greenhand520/AutomaticObstacleAvoidanceTrolleyWithC51/(list of files, drawings)

Other design files:
简易仿真图/car.pdsprj
