greenhand520/AutomaticObstacleAvoidanceTrolleyWithC51/(commit log)

2018-11-26 20181126 1934 第2次提交
    update readme.md；
    添加材料清单；
    用python写了个简易控制小车的上位机代码
2018-11-28 20181128 2148 第3次提交
    基本小车代码的框架；
    用Proteus弄了个简易的仿真；
    bug还有很多，慢慢修复。
    [car.pdsprj]
2018-12-09 20181209 2253第4次提交
    将L298N换成TB6612FNG，方便PWM调速。
    完成蓝牙控制小车与调速。
    [car.pdsprj]
2018-12-14 20181214 2251 第5次提交
    舵机可以根据避障传感器转动方向；
    超声波可以测距，测距数据不准；
    还有很多bug和功能要写，加油！
    [car.pdsprj]
2018-12-24 20181224 2253 第6次提交
    算是完成了所有的功能了
    [car.pdsprj]
2018-12-29 20181229 0909 第7次提交
    补全了仿真图；
    优化了避障功能，但仍存在bug；
    [car.pdsprj]
2018-12-29 20181229 0924 第8次提交
    update readme.md
